VITAZGIO/ESP32_MasterFanServer/(commit log)

2026-06-03 Кулер
2026-06-21 топики
